DmitryPertsev/MiniRobot/README.md

# Robo
Multitasking robot with face recognition and voice assistant features - Мультизадачный робот с возможностью распознавания лиц и голосвого ассистента
Для дальнейшего ознакомления с проектом используйте документацию в каталоге "User Documentation"
