DmitryPertsev/MiniRobot/EasyEDA/Amplifier/Schematic_Amplifier shield.pdf

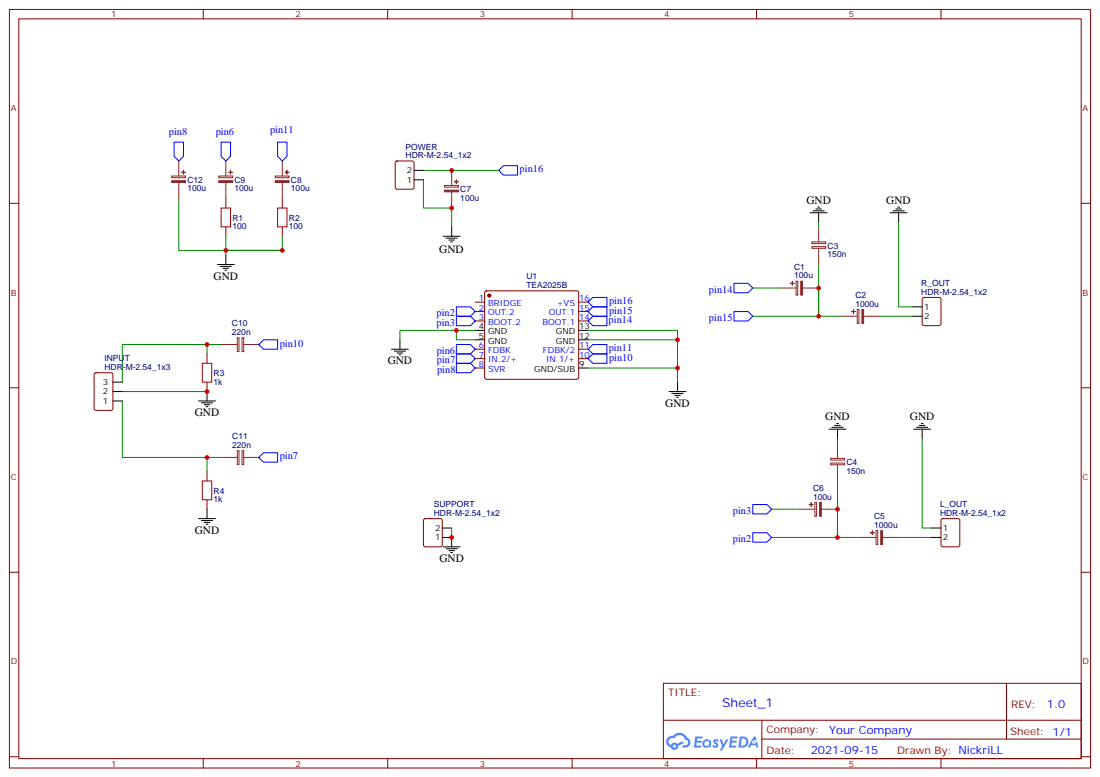
[picture p59: page 1]

TEA2025B
IN.1/+ 10 FDBK/2 11 GND 12 GND 13 BOOT.1 14 OUT.1 15 +VS 16
