DmitryPertsev/MiniRobot/RemoteControl/EasyEda/Schematic_Robot_control_2023-02-04.pdf

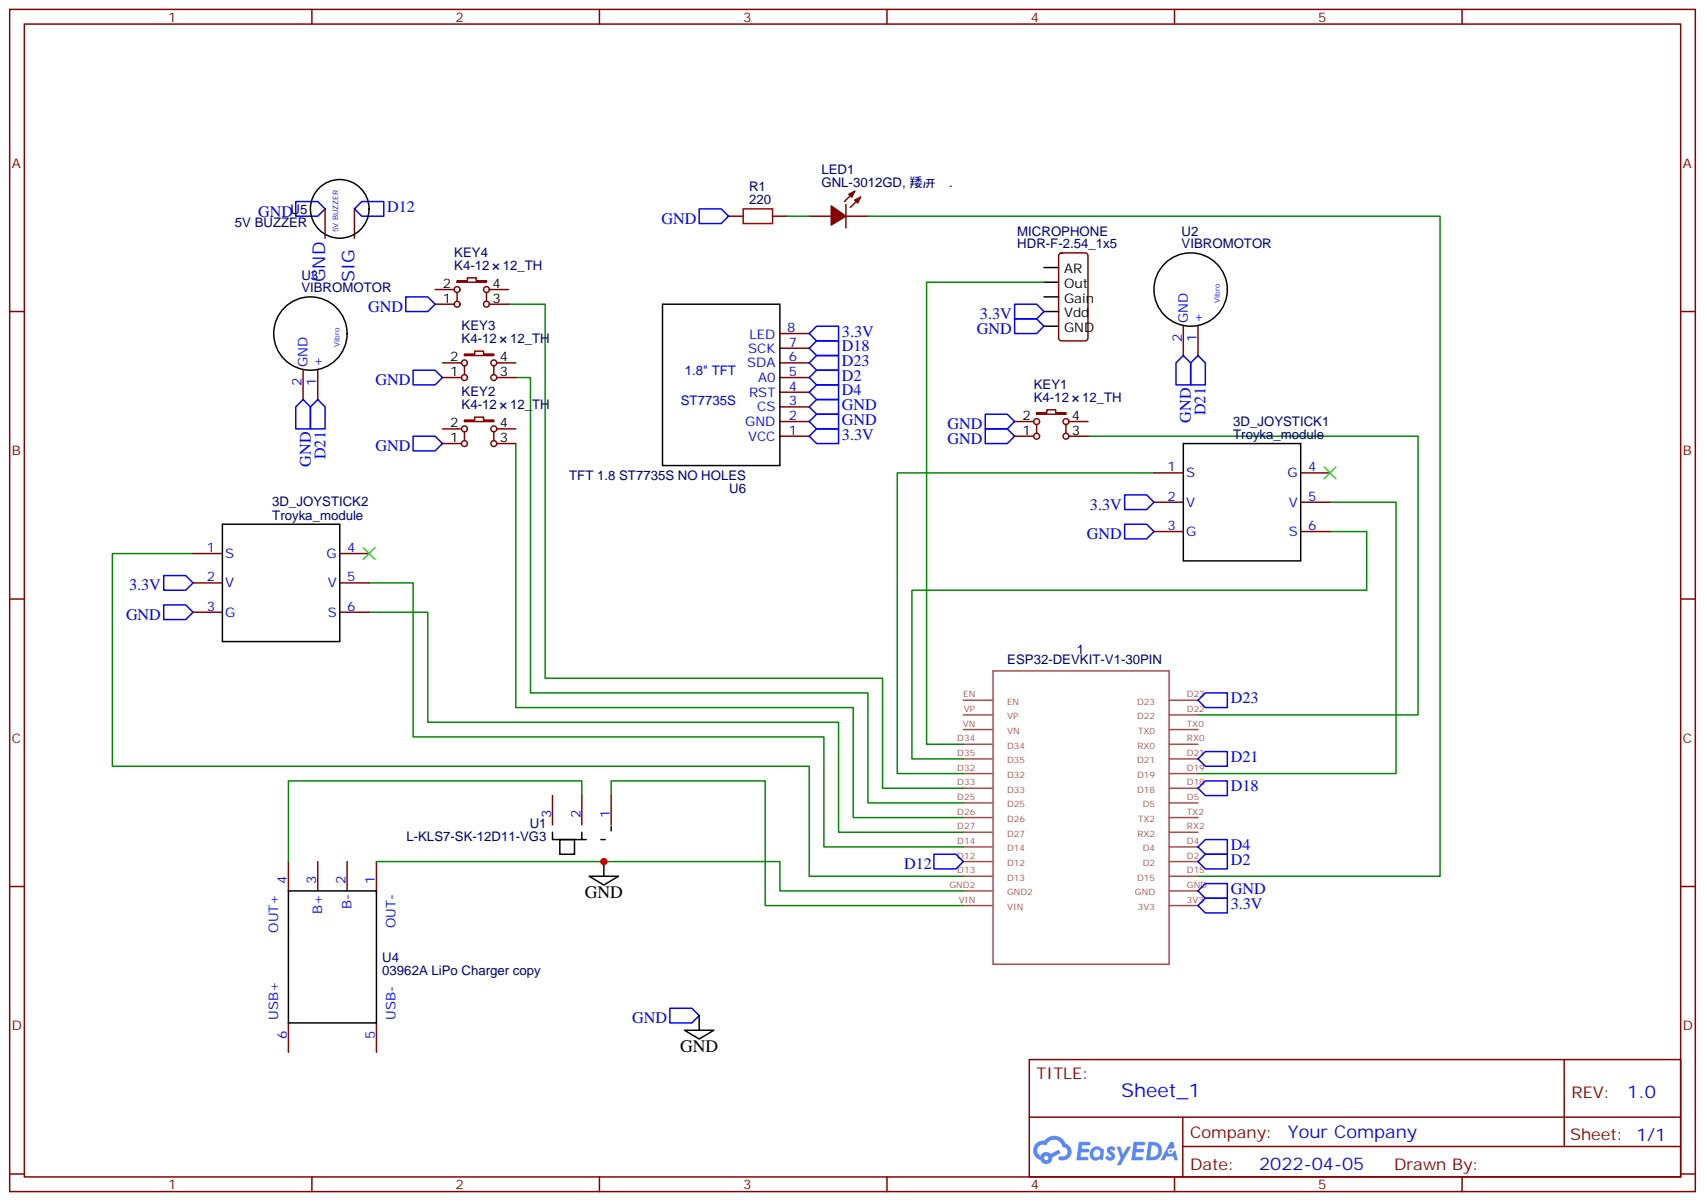
[picture p60: page 1]
