DmitryPertsev/MiniRobot/EasyEDA/Arduino/Schematic_PowerManager.pdf

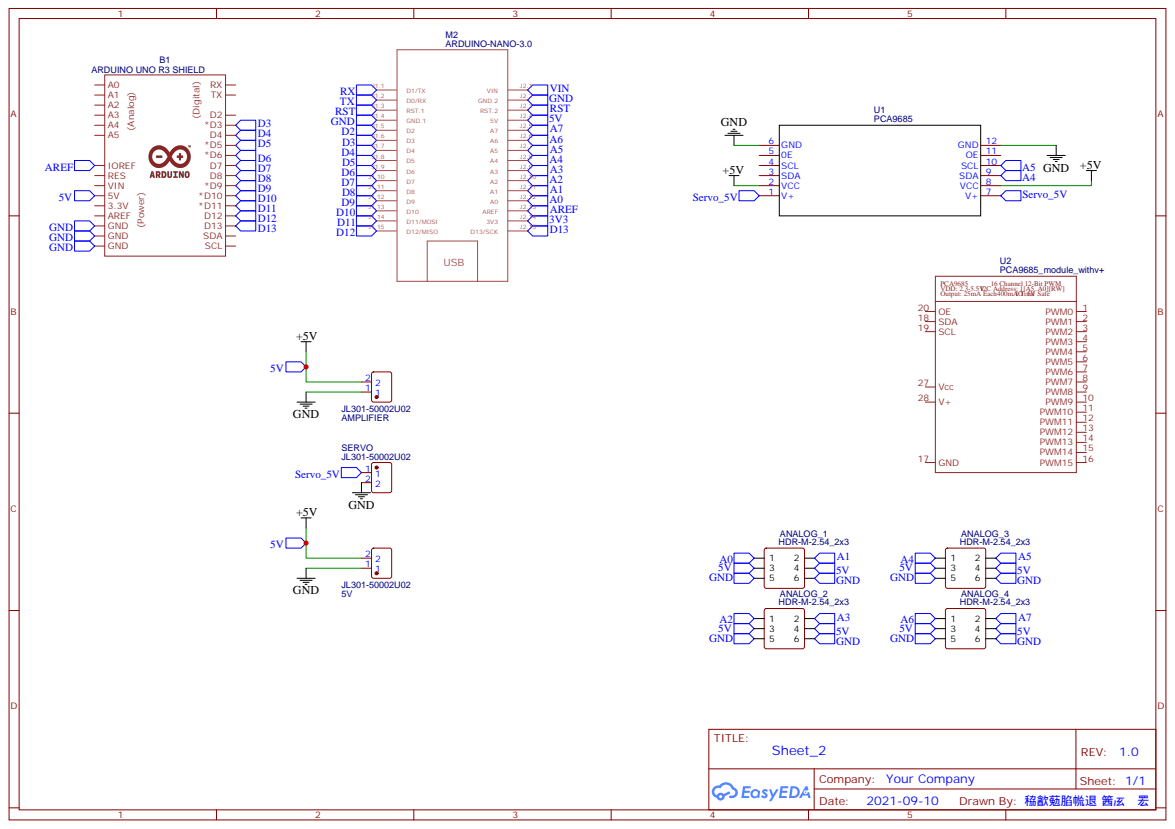
[picture p61: page 1]

Drawn By: 䅄㱃葂䐄㡃退 䇴㕄ц䍔㈀
