DmitryPertsev/MiniRobot/EasyEDA/PowerManager/Schematic_PowerManager.pdf

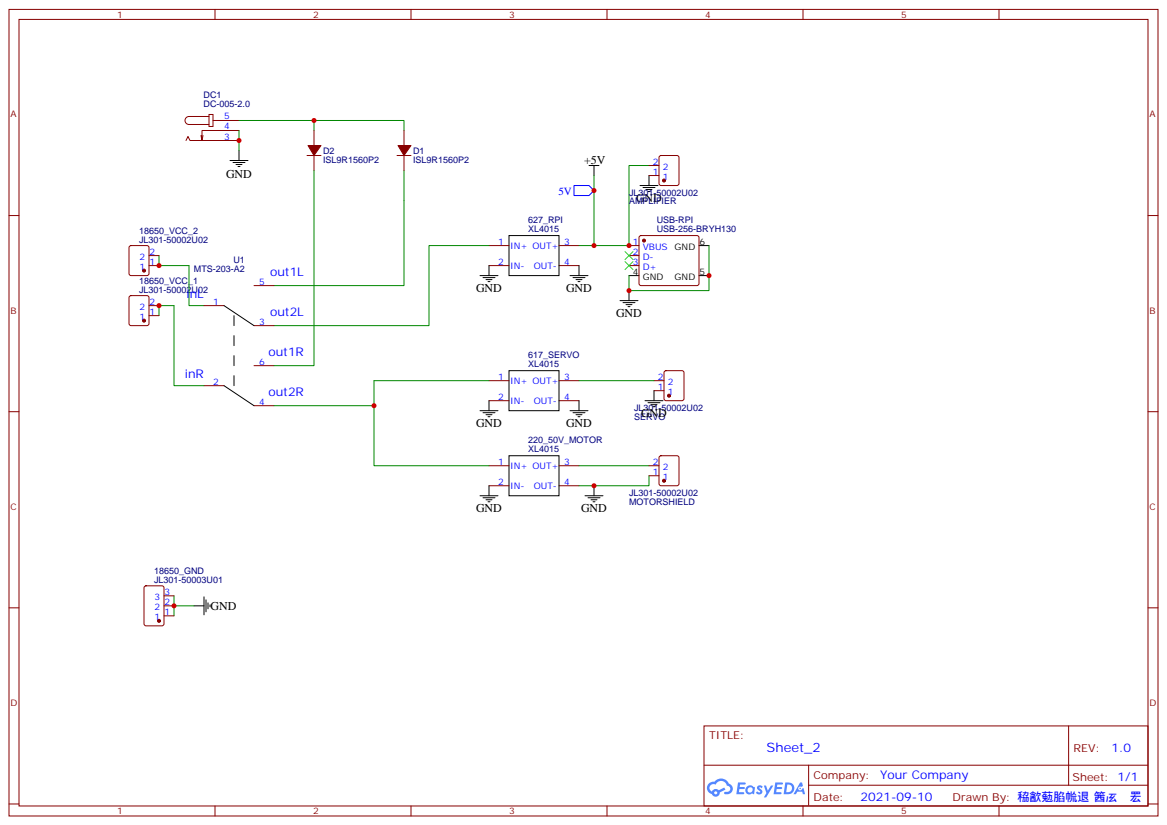
[picture p62: page 1]

Drawn By: 䅄㱃葂䐄㡃退 䇴㕄ц䍔㈀
