DmitryPertsev/MiniRobot/EasyEDA/Soundcard/Schematic_soundcard adapter.pdf

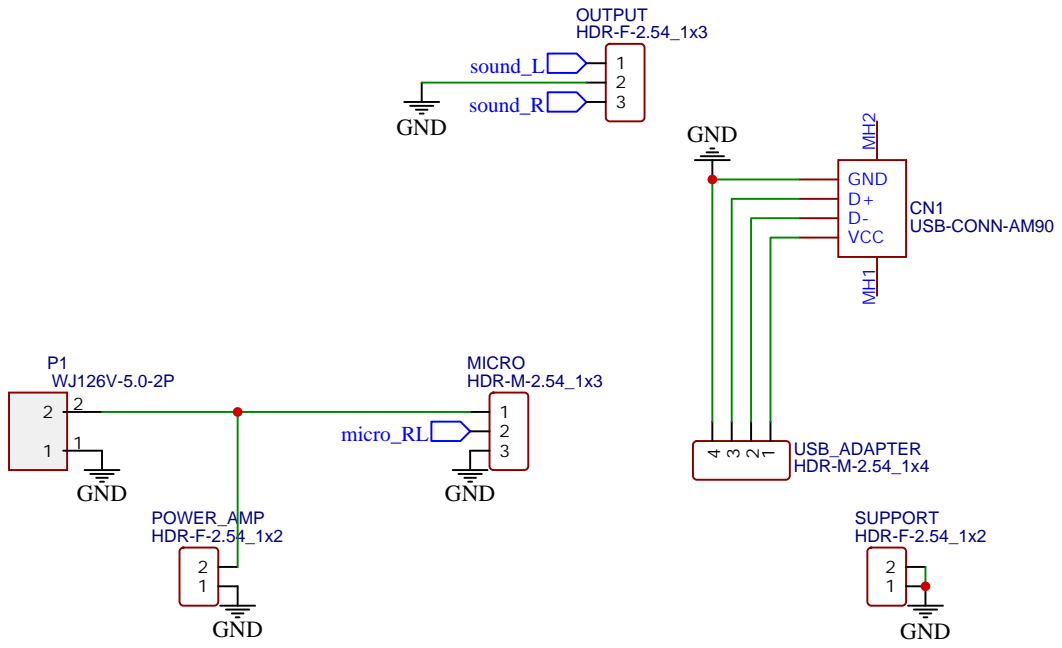
[picture p63: page 1]
