DmitryPertsev/MiniRobot/(list of files, drawings)

Other design files:
EasyEDA/Amplifier/EasyEDA_PCB_Amplifier shield.json
EasyEDA/Amplifier/EasyEDA_SCH_Amplifier shield.json
EasyEDA/Arduino/EasyEDA_PCB.json
EasyEDA/Arduino/EasyEDA_SCH_PowerManager.json
EasyEDA/PowerManager/EasyEDA_PCB.json
EasyEDA/PowerManager/EasyEDA_SCH_PowerManager.json
EasyEDA/Soundcard/EasyEDA_PCB_soundcard adapter.json
EasyEDA/Soundcard/EasyEDA_SCH_soundcard adapter.json
RemoteControl/EasyEda/PCB_PCB_Robot_control_8_2023-02-04.json
RemoteControl/EasyEda/SCH_Robot_control_2023-02-04.json
