DmitryPertsev/MiniRobot/RemoteControl/ESP32_Library/ESPManager.h

//
// Created by Anzhalika Dziarkach on 03.04.2022.
//

#ifndef ESPMANAGER_H
#define ESPMANAGER_H

#include "ControlController.h"
#include "DisplayMenuController.h"
#include "WifiController.h"
#include "Arduino.h"

class ESPManager {
public:
    ESPManager();
    ~ESPManager();

    void begin();
    void handle();

private:
    ControlController controlController;
    DisplayMenuController displayMenuController;
    WifiController wifiController;
};


#endif //ESPMANAGER_H
