DmitryPertsev/MiniRobot/Arduino_Library/BatteryChargeMeasurer.h

#ifndef BatteryChargeSensor_H
#define BatteryChargeSensor_H

#include "Arduino.h"
constexpr float R1 = 100000;
constexpr float R2 = 51000;

class BatteryChargeMeasurer
{
public:
    BatteryChargeMeasurer();
    BatteryChargeMeasurer(int voltPin);
    ~BatteryChargeMeasurer();

    void init(int voltPin);
    float read();
    float getCurrentState();

private:
    int mVoltPint;
    float mVoltage;
};

#endif
