DmitryPertsev/MiniRobot/Arduino_Library/LocationAnalysisCommand.cpp

#include "LocationAnalysisCommand.h"

LocationAnalysisCommand::LocationAnalysisCommand()
{
    mLocationState = "";
}

LocationAnalysisCommand::~LocationAnalysisCommand() 
{
}

void LocationAnalysisCommand::execute()
{
    //IRSensor.read();
    int * irSensorsState = IRSensor.getResultAsArray();
    int distance = USSensor.read();
    //int lightLevel = PSSensor.read();
    mLocationState = "";
    mLocationState += "I:";
    mLocationState += irSensorsState[0];
    mLocationState += ",";
    mLocationState += irSensorsState[1];
    mLocationState += ",";
    mLocationState += irSensorsState[2];
    mLocationState += ",";
    mLocationState += irSensorsState[3];
    mLocationState += "U:";
    mLocationState += distance;
    mLocationState += "L:";
    mLocationState += 0; // lightLevel;
    mLocationState += "\n";
};

const char * LocationAnalysisCommand::getResultString()
{
    return mLocationState.c_str();
}

LocationAnalysisCommand * LocationAnalysisCommand::init()
{
    USSensor.init(trigPin, echoPin);
    PSSensor.init(lightSensorPin);
    IRSensor.init(ikCenter, ikLeft, ikRight, ikBack);
}
