DmitryPertsev/MiniRobot/Arduino_Library/SerialIntercommunicator.cpp

#include "SerialIntercommunicator.h"
#define MOVE_STOP -1
#define MOVE_LEFT 0
#define MOVE_FORWARD 1
#define MOVE_RIGHT 2
#define MOVE_BACK 3

SerialIntercommunicator::SerialIntercommunicator()
{
    Serial.begin(250000);

    while (!Serial) {
        ; // wait for serial port to connect. Needed for native USB port only
    }

    Serial.println("Serial loaded");
    locationCommand.init();
}

SerialIntercommunicator::~SerialIntercommunicator() {}

void SerialIntercommunicator::run()
{
    if (read())
    {
        Serial.println("intercomm");
        Serial.println(mCommand.c_str());

        switch (mCommand[0]) {
        case 'v': servoCommand.init(0, mParameter.toInt())->execute(); break;
        case 'h': servoCommand.init(1, mParameter.toInt())->execute(); break;
        case 's': motorCommand.init(MOVE_STOP)->execute(); break;
        case 'f': motorCommand.init(MOVE_FORWARD)->execute(); break;
        case 'b': motorCommand.init(MOVE_BACK)->execute(); break;
        case 'l': motorCommand.init(MOVE_LEFT, mParameter.toInt())->execute(); break;
        case 'r': motorCommand.init(MOVE_RIGHT, mParameter.toInt())->execute(); break;
        case 'o':
                  locationCommand.execute();
                  write(locationCommand.getResultString());
                  break;
        case 't': write(batteryController.run()); break;
        default:
            break;
        }
    }
    else
    {
        //locationCommand.execute();
        //write(locationCommand.getResultString());
    }
}

boolean SerialIntercommunicator::read()
{
    if (Serial.available() > 0) {
        mCommand = Serial.readString();
        mParameter = mCommand.substring(1);
        return true;
    }
    return false;
}

void SerialIntercommunicator::write(const char * data)
{
    Serial.write(data);
}

void SerialIntercommunicator::write(const byte data)
{
    Serial.write(data);
}

void SerialIntercommunicator::write(const int data)
{
    Serial.print(data);
}
