DmitryPertsev/MiniRobot/Arduino_Library/pch.h

#ifndef PCH_H
#define PCH_H

int ikCenter = 14;
int ikLeft = 15; 
int ikRight = 16;
int ikBack = 17; 


int trigPin = 10; 
int echoPin = 9;

int lightSensorPin = 18;


int  VOLT_PIN = 20

#define R1 100000             
#define R2 51000

#define SERVOMIN  150 
#define SERVOMAX  550 
#define SERVOPORT0 0 
#define SERVOPORT1 1

#define PWM_FREQ 60
#endif
