DmitryPertsev/MiniRobot/(commit log)

2020-10-10 - update source code
    - add mobile application code
    - add diploma materials
2021-12-28 add required circuits
    [EasyEDA_PCB.json, EasyEDA_PCB_Amplifier shield.json, EasyEDA_PCB_soundcard adapter.json, EasyEDA_SCH_Amplifier shield.json, EasyEDA_SCH_PowerManager.json, EasyEDA_SCH_soundcard adapter.json]
2023-02-05 add remote control
    [PCB_PCB_Robot_control_8_2023-02-04.json, SCH_Robot_control_2023-02-04.json]
